hugonl31/Vectrex_Cart_PCB/boards/v1_27c512_64k/images/render_top.png

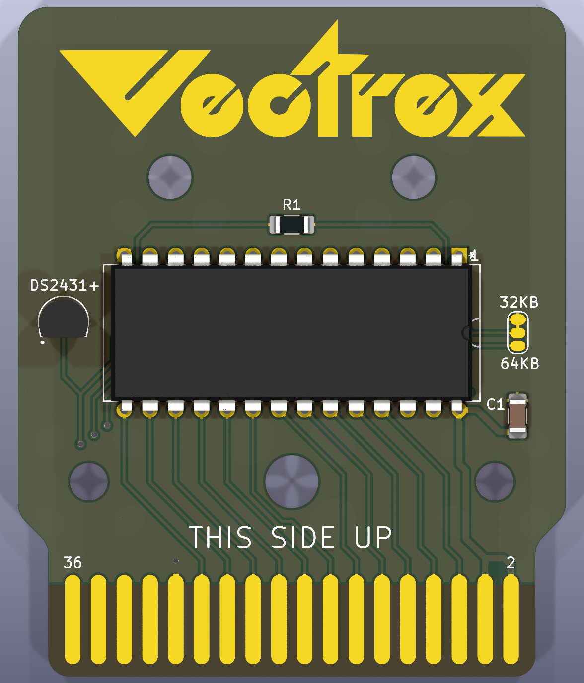
boards/v1_27c512_64k/images/render_top.png
