hugonl31/Vectrex_Cart_PCB/boards/v2_512k_flash/images/render_top.png

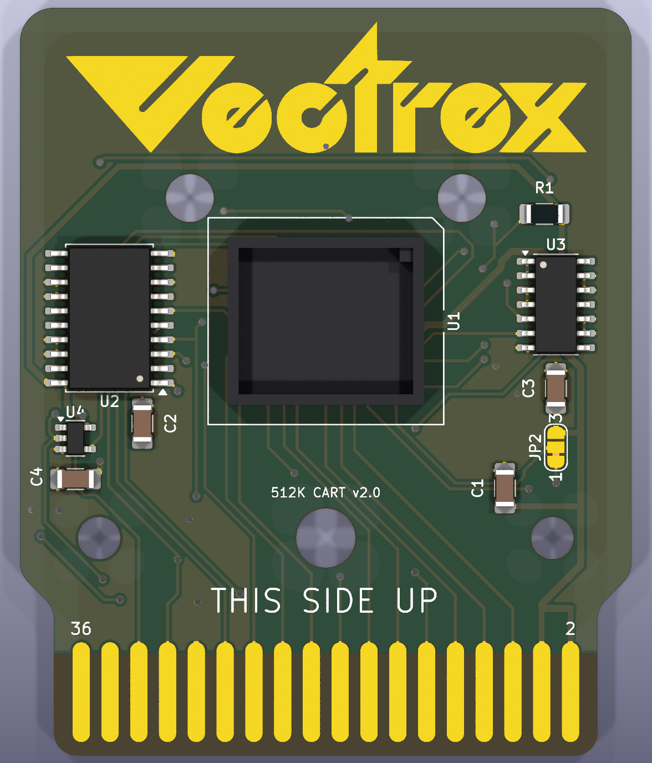
boards/v2_512k_flash/images/render_top.png
