hugonl31/Vectrex_Cart_PCB/case/images/Vectrex_cart_back.png

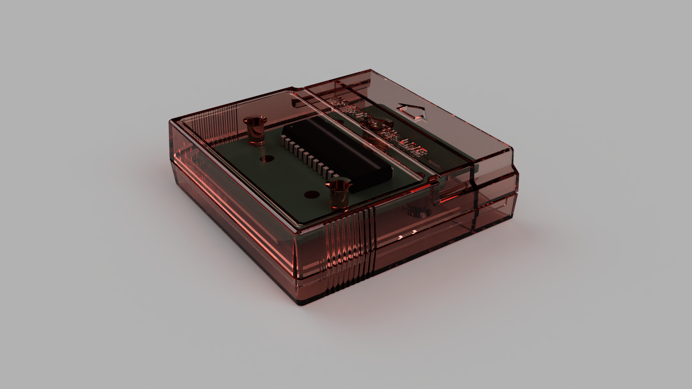
case/images/Vectrex_cart_back.png
