hugonl31/Vectrex_Cart_PCB/case/Vectrex_case_M3_top.stl

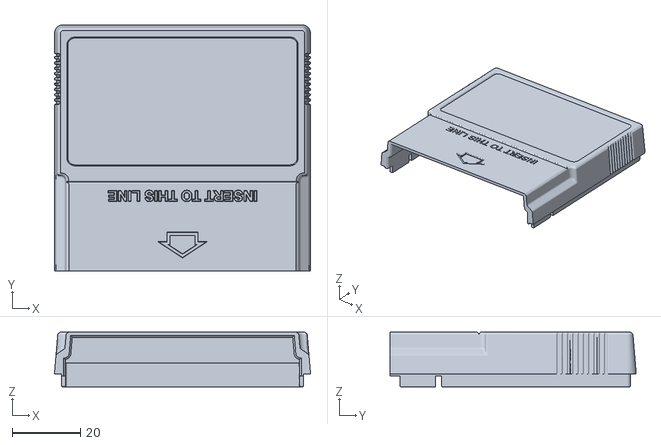
[picture p12: CAD file, 2026-10-23]
case/Vectrex_case_M3_top.stl
74.8 x 72.0 x 16.0
