hugonl31/Vectrex_Cart_PCB/case/Vectrex_case_M3_bottom.stl

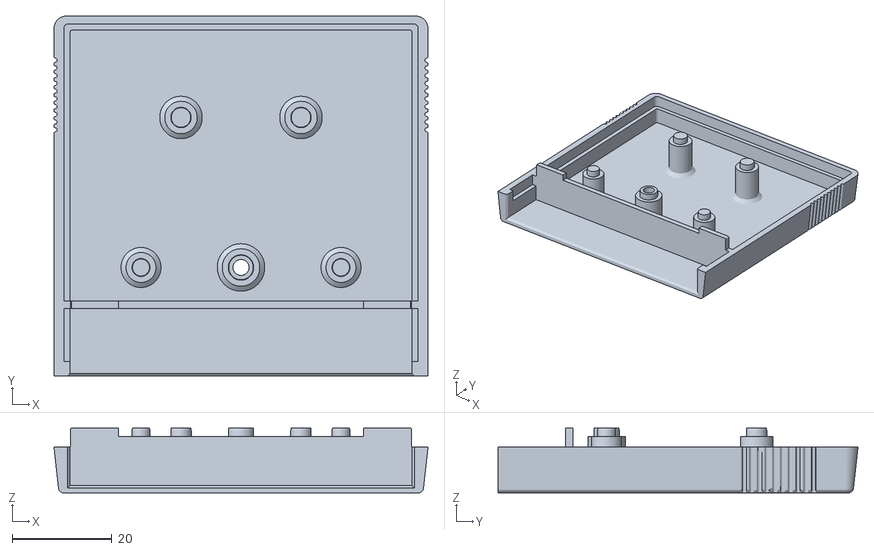
[picture p13: CAD file, 2026-10-23]
case/Vectrex_case_M3_bottom.stl
74.8 x 72.0 x 13.0
