hugonl31/Vectrex_Cart_PCB/case/interface_test.stl

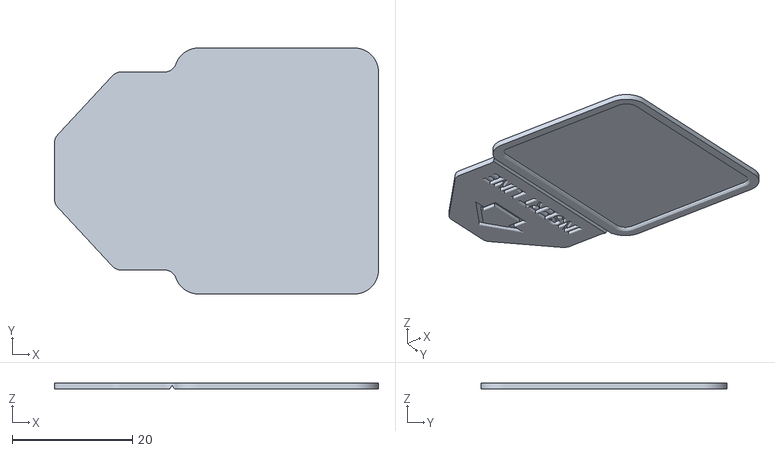
[picture p14: CAD file, 2026-10-23]
case/interface_test.stl
54.0 x 41.0 x 1.00
