hugonl31/Vectrex_Cart_PCB/boards/v2_512k_flash/vectrex-cartridge-512k.kicad_pcb

## KiCad design boards/v2_512k_flash/vectrex-cartridge-512k.kicad_pcb (2026-10-24)

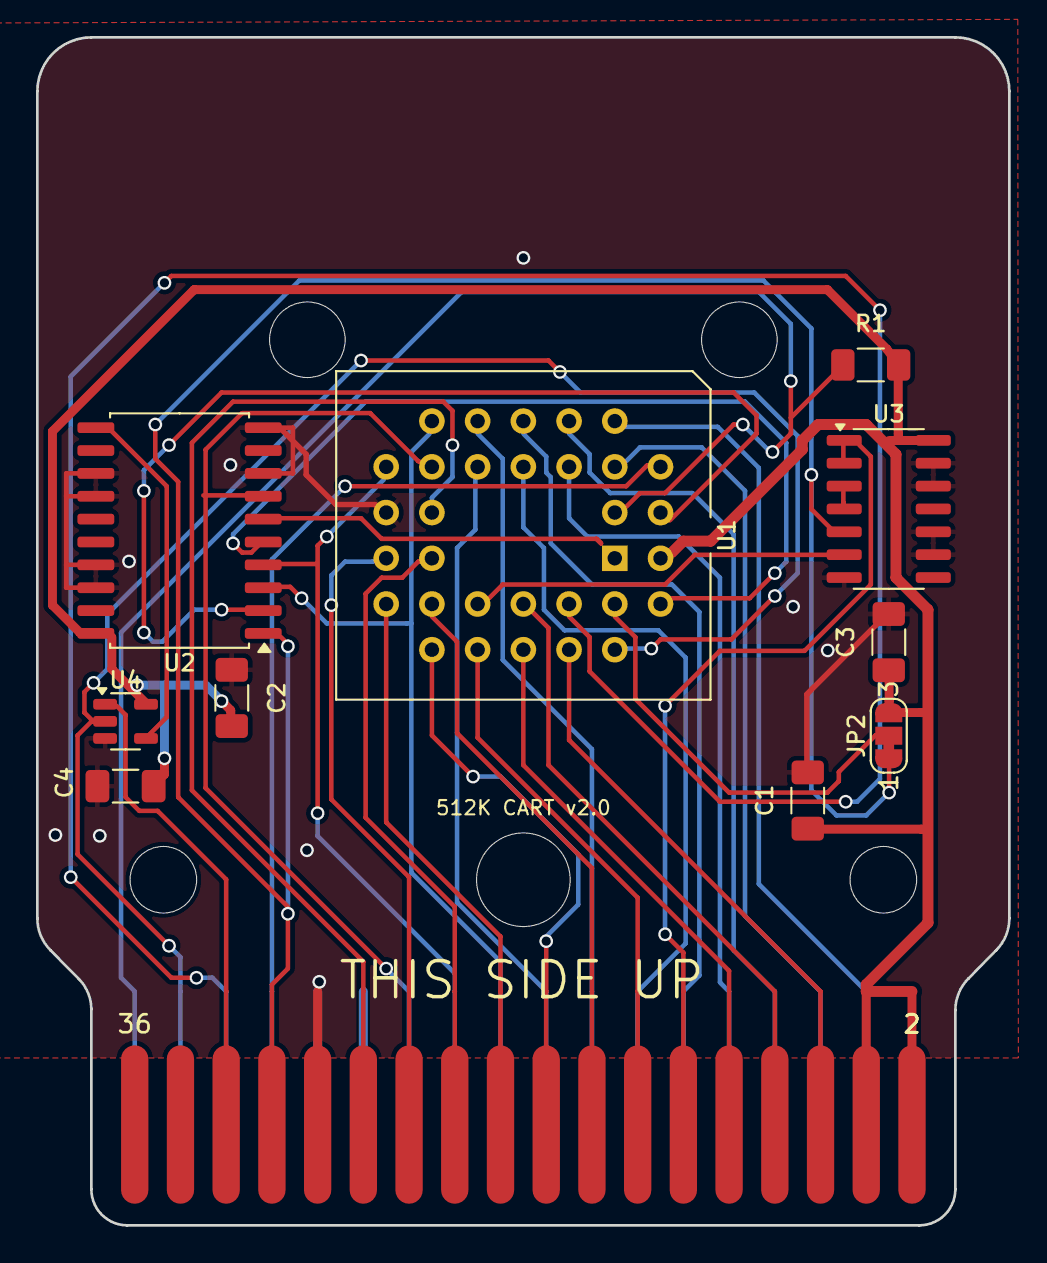
[picture p15: board vectrex-cartridge-512k.kicad_pcb from above]

Board: 2 copper layers, 54.0 x 66.0 mm, 18 parts (1 on the bottom side), 37 nets.

Parts:
C1, C2, C3, C4: 100nF; C1_hand_1206_3216Metric_Pad1.33x1.80mm_HandSolder
CON1: vectrex-edge-connector; vectrex-edge-connector-thinner-no-soldermask
G1: LOGO; vectrex-us-soldermask
G3: LOGO; vectrex-uk-soldermask
H1, H3: 3.7mm; Mounting_Hole_D3.7mm
H2: 5.2mm; Mounting_Hole_D5.2mm
H4, H5: 4.2mm; Mounting_Hole_D4.2mm
JP2: FLASH /WE; SolderJumper-3_P1.3mm_Bridged12_RoundedPad1.0x1.5mm_NumberL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
R1: 3.3K; R1_1206_3216Metric_Pad1.30x1.75mm_HandSolder
U1: SST39SF040 (PLCC-32 socket); PLCC-32_THT-Socket
U2: 74HC377; SOIC-20W_7.5x12.8mm_P1.27mm
U3: 74HC00; SOIC-14_3.9x8.7mm_P1.27mm
U4: 74HC1G32; SOT-23-5

Connections:
+5V: C1.1, C2.1, C3.1, C4.1, CON1.2, CON1.4, JP2.3, R1.2, U1.32, U2.20, U3.14, U4.5
BA16: U1.2, U2.2
BA17: U1.30, U2.5
BA18: U1.1, U2.6
C_A0: CON1.17, U1.12
C_A1: CON1.15, U1.11
C_A2: CON1.13, U1.10
C_A3: CON1.11, U1.9
C_A4: CON1.9, U1.8
C_A5: CON1.7, U1.7
C_A6: CON1.5, U1.6
C_A7: CON1.3, U1.5
C_A8: CON1.6, U1.27
C_A9: CON1.8, U1.26
C_A10: CON1.14, U1.23
C_A11: CON1.10, U1.25
C_A12: CON1.29, U1.4
C_A13: CON1.31, U1.28
C_A14: CON1.33, U1.29, U4.2
C_D0: CON1.19, U1.13, U2.3
C_D1: CON1.21, U1.14, U2.4
C_D2: CON1.23, U1.15, U2.7
C_D3: CON1.26, U1.17
C_D4: CON1.24, U1.18
C_D5: CON1.22, U1.19
C_D6: CON1.20, U1.20
C_D7: CON1.18, U1.21
E: U3.3, U3.4
FL_OE: U1.24, U3.6
FL_WE: JP2.2, U1.31
GND: C1.2, C2.2, C3.2, C4.2, CON1.25, CON1.27, CON1.28, U1.16, U2.8, U2.10, U2.13, U2.14, U2.17, U2.18, U3.7, U3.9, U3.10, U3.12, U3.13, U4.3
LCLK: U2.11, U4.4
V-CART: CON1.32, U4.1
V-CE: CON1.16, U1.22
V-OE: CON1.12, U3.1, U3.2
V-PB6: CON1.35, R1.1, U1.3
V-RW: CON1.30, JP2.1, U2.1, U3.5
