hugonl31/Vectrex_Cart_PCB/boards/v1_27c512_64k/vectrex-cartridge-64k.kicad_pcb

## KiCad design boards/v1_27c512_64k/vectrex-cartridge-64k.kicad_pcb (2026-10-23)

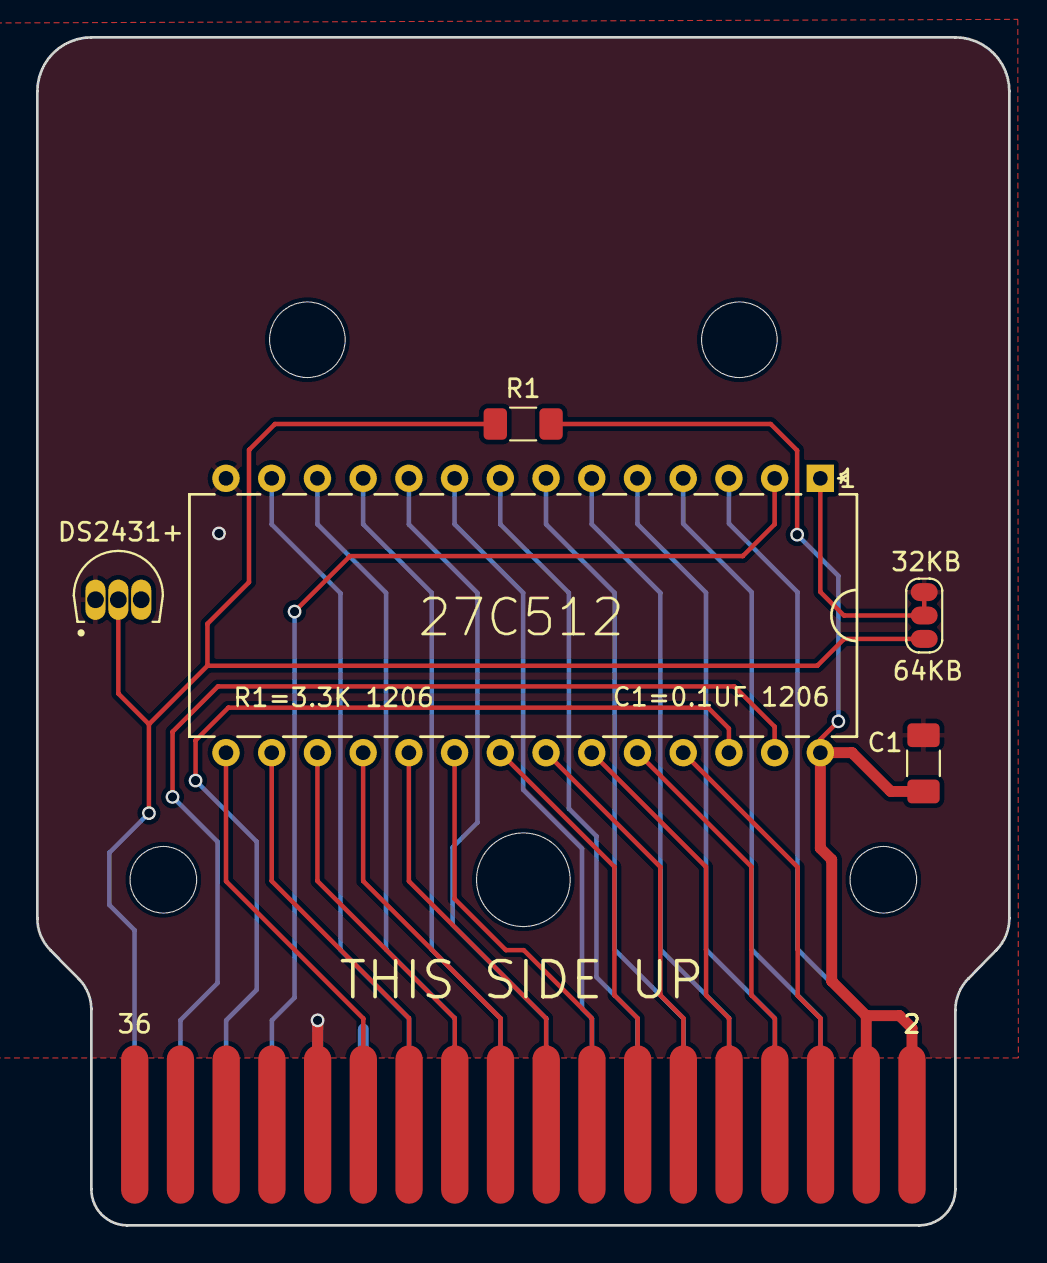
[picture p16: board vectrex-cartridge-64k.kicad_pcb from above]

Board: 2 copper layers, 54.0 x 66.0 mm, 8 parts (1 on the bottom side), 2 nets.

Parts:
CON1: vectrex-edge-connector; vectrex-edge-connector-thinner-no-soldermask
G1: LOGO; vectrex-us-soldermask
G3: LOGO; vectrex-uk-soldermask
H1, H3: 3.7mm; Mounting_Hole_D3.7mm
H2: 5.2mm; Mounting_Hole_D5.2mm
H4, H5: 4.2mm; Mounting_Hole_D4.2mm

Connections:
+5V: CON1.2, CON1.4
GND: CON1.25, CON1.27, CON1.28
