hugonl31/Vectrex_Cart_PCB/(commit log)

2026-10-23 Vectrex cartridge PCBs: the 64K, 8K GCE and 512K boards, the early boards and the shell
    KiCad 9 boards with Gerbers, 3D renders, copper layers and schematics drawn from the boards,
    the 3D-printable shell (STL), and the KiCad libraries. CERN-OHL-P-2.0.
    [Vectrex_case_M3_bottom.stl, Vectrex_case_M3_top.stl, interface_test.stl, vectrex-cartridge-27c512.kicad_pcb, vectrex-cartridge-28c64.kicad_pcb, vectrex-cartridge-512k.kicad_pcb, vectrex-cartridge-64k.kicad_pcb, vectrex-cartridge-8k-gce.kicad_pcb]
2026-10-23 512K board: renders with the SST39SF040 in place
2026-10-23 Without the early boards
    [vectrex-cartridge-27c512.kicad_pcb, vectrex-cartridge-28c64.kicad_pcb, vectrex-cartridge-duo.kicad_pcb]
2026-10-23 512K board: a PLCC-32 socket model of our own (KiCad has none), renders with the flash in it
    [vectrex-cartridge-512k.kicad_pcb]
2026-10-24 512K board: routed with a router of our own - straight bus lanes, 0/45/90 degree tracks
    The PLCC socket turned and moved up so the address bus reaches it from inside; the latch's
    unused inputs D4-D8 tied to GND; unused fingers (/HALT, /NMI, /IRQ) without copper. DRC with
    the project's rules: no unconnected items, no clearance errors. New renders, copper layers,
    schematic and Gerbers; routing/ holds the router and its plan (route.py removed).
    [vectrex-cartridge-512k.kicad_pcb]
